GabrielChuffart/WingECU/firmware/wing-ecu/Core/Inc/main.h

#define RCC_OSC32_IN_Pin GPIO_PIN_14
#define RCC_OSC32_IN_GPIO_Port GPIOC
#define RCC_OSC32_OUT_Pin GPIO_PIN_15
#define RCC_OSC32_OUT_GPIO_Port GPIOC
#define RCC_OSC_IN_Pin GPIO_PIN_0
#define RCC_OSC_IN_GPIO_Port GPIOF
#define RCC_OSC_OUT_Pin GPIO_PIN_1
#define RCC_OSC_OUT_GPIO_Port GPIOF
#define LPUART1_TX_Pin GPIO_PIN_2
#define LPUART1_TX_GPIO_Port GPIOA
#define LPUART1_RX_Pin GPIO_PIN_3
#define LPUART1_RX_GPIO_Port GPIOA
#define LED_Pin GPIO_PIN_5
#define LED_GPIO_Port GPIOA
#define T_SWDIO_Pin GPIO_PIN_13
#define T_SWDIO_GPIO_Port GPIOA
#define T_SWCLK_Pin GPIO_PIN_14
#define T_SWCLK_GPIO_Port GPIOA
#define DBG0_Pin GPIO_PIN_10
#define DBG0_GPIO_Port GPIOC
#define DBG1_Pin GPIO_PIN_11
#define DBG1_GPIO_Port GPIOC
#define T_SWO_Pin GPIO_PIN_3
#define T_SWO_GPIO_Port GPIOB
