GabrielChuffart/WingECU/(commit log)

2026-10-20 Add MATLAB sizing: hinge moment (s01), torque scale factor (s02)
    updated README and roadmap with new scale factor
2026-10-20 Add s03: inertia, return spring, torque budget
2026-10-22 Add estimated BOM
    [bom.xlsx]
2026-10-22 Move bench supply to 24V, update motor model, proposal and BOM
    [bom.csv]
2026-10-22 Add WingECU CubeMX project : 170Mhz HSE clock, FreeRTOS, LPUART1, debug GPIOs
    [bom.xlsx]
